JenovaCell/zero-rax/concept_b_stack.png

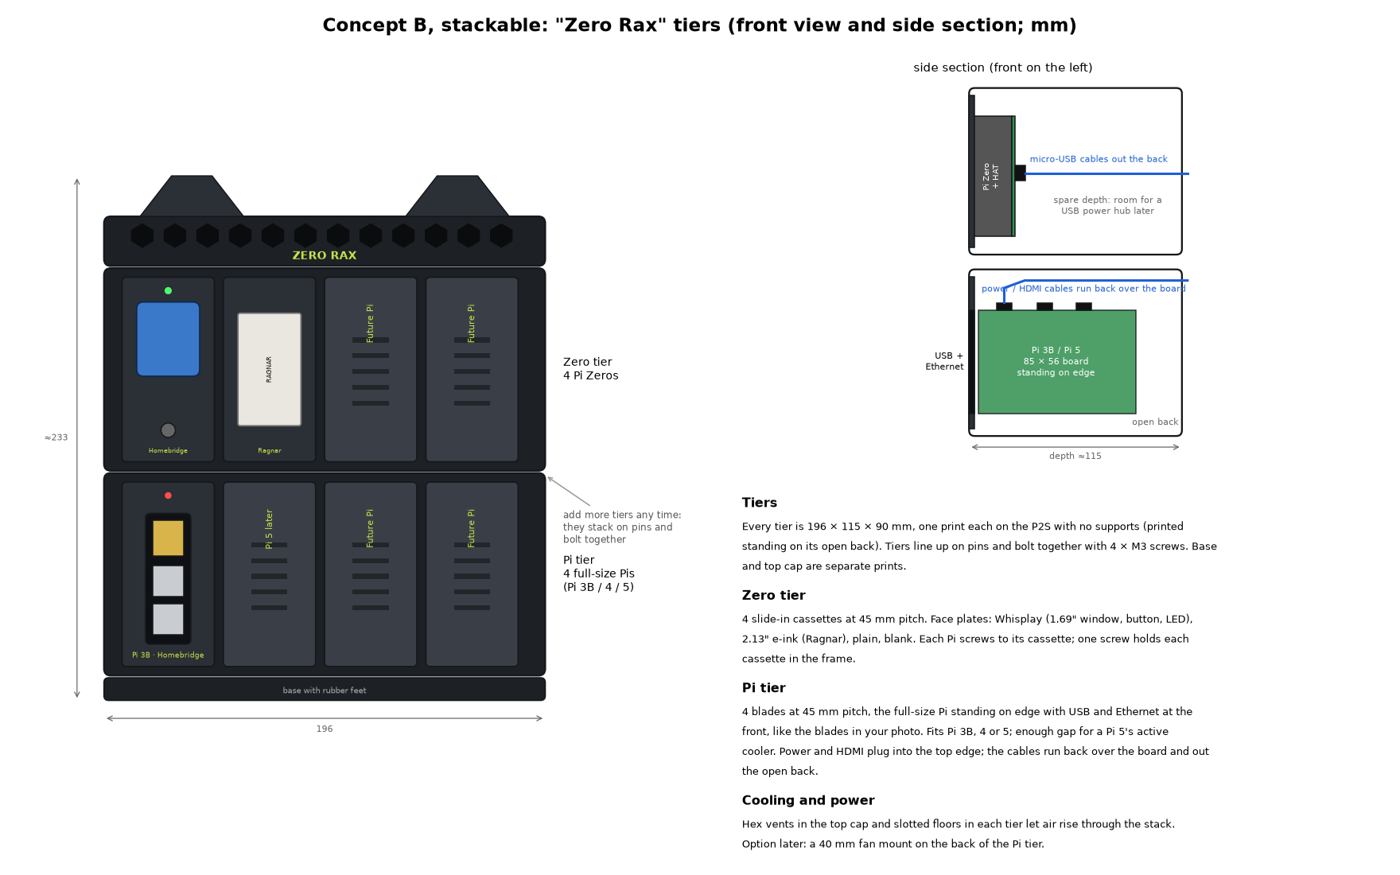
concept_b_stack.png
