JenovaCell/zero-rax/concepts.png

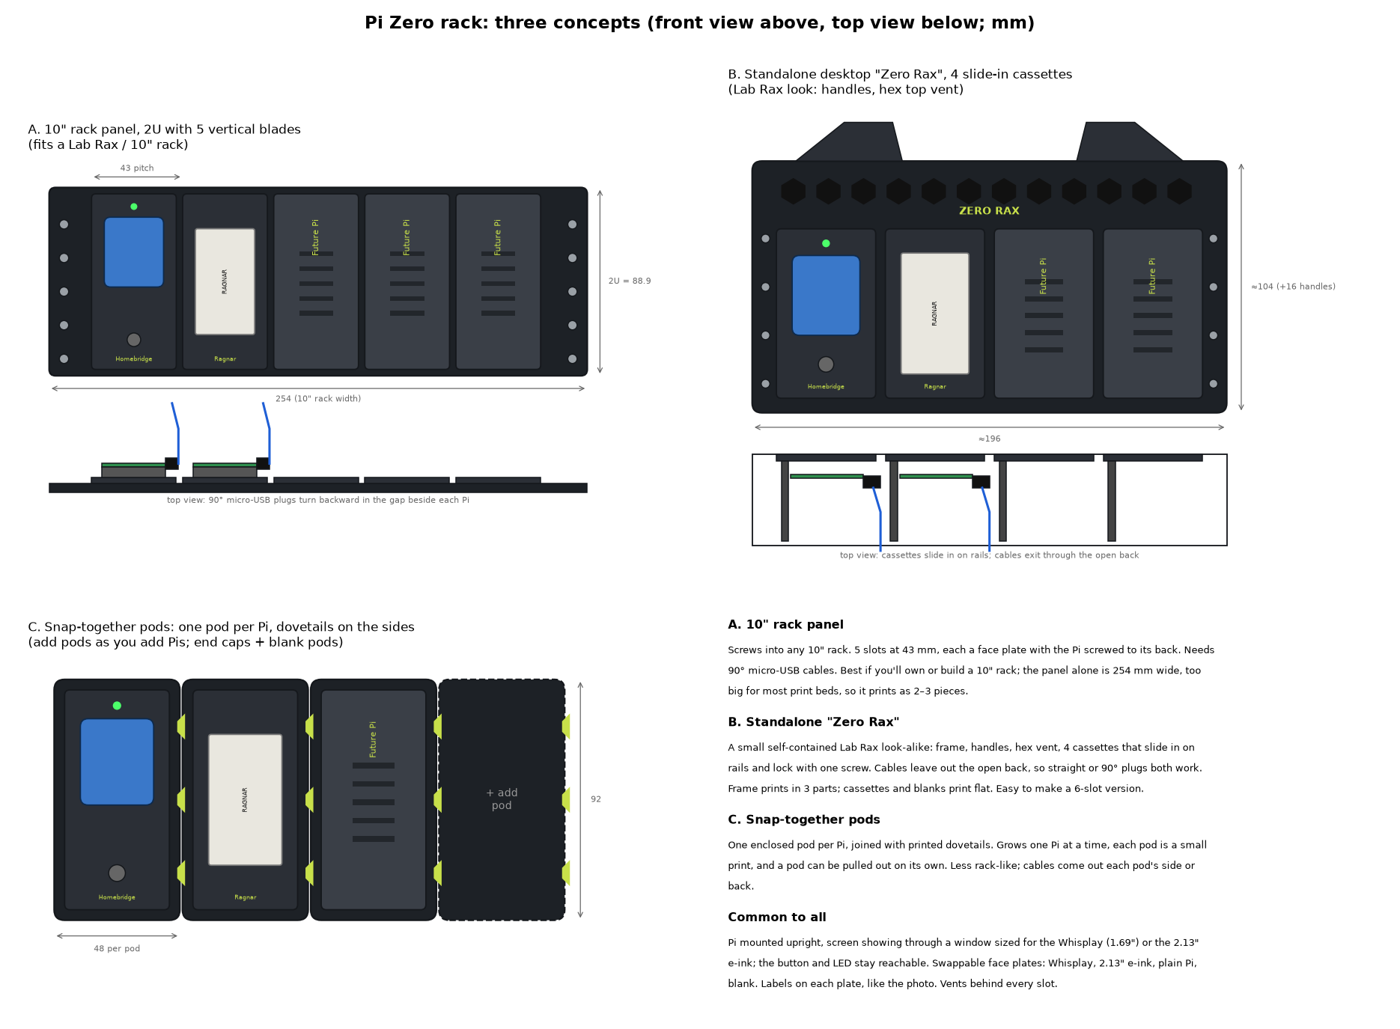
concepts.png
