JenovaCell/zero-rax/renders/straight_front.png

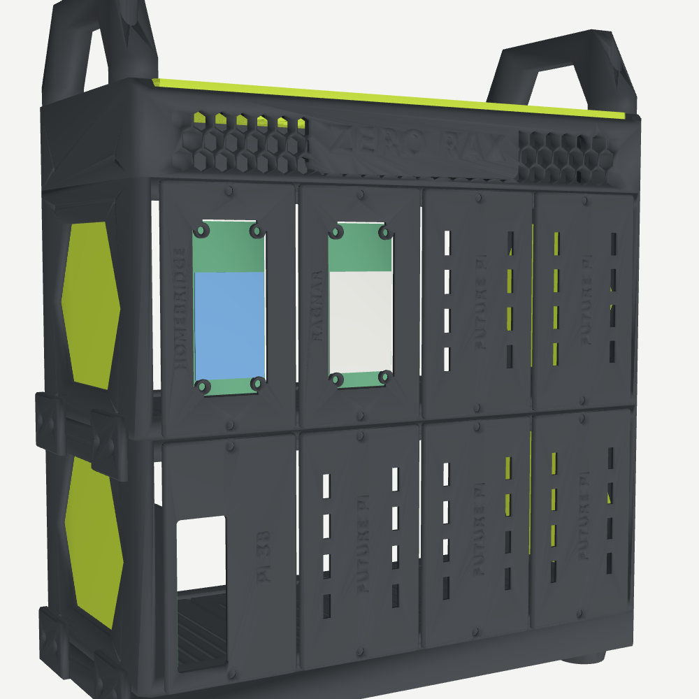
renders/straight_front.png
