JenovaCell/zero-rax/stl/cassette_homebridge.stl

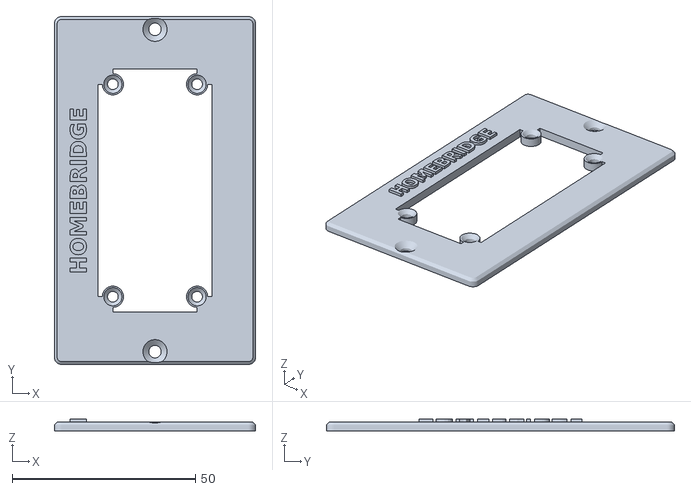
[picture p6: CAD file, 2026-09-28]
stl/cassette_homebridge.stl
55.0 x 95.0 x 3.30
