JenovaCell/zero-rax/zero_rax_black_plate4.3mf

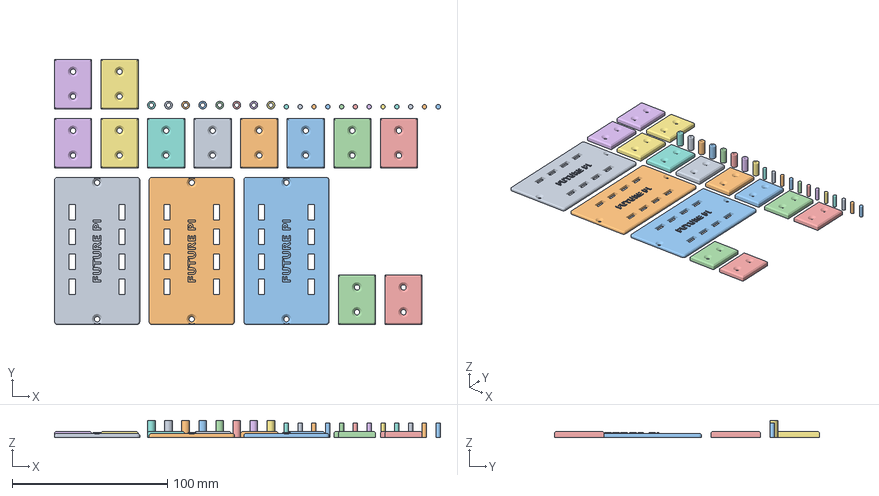
[picture p7: CAD file, 2026-09-28]
zero_rax_black_plate4.3mf
248.8 x 171.0 x 11.0 mm
blank_future_pi_0
blank_future_pi_1
blank_future_pi_2
clip_3
clip_4
clip_5
clip_6
clip_7
clip_8
clip_9
clip_10
clip_11
clip_12
clip_13
clip_14
zero_spacer_15
zero_spacer_16
zero_spacer_17
zero_spacer_18
zero_spacer_19
zero_spacer_20
zero_spacer_21
zero_spacer_22
dowel_23
dowel_24
dowel_25
dowel_26
dowel_27
dowel_28
dowel_29
dowel_30
dowel_31
dowel_32
dowel_33
dowel_34
