JenovaCell/zero-rax/stl/blade_pi3b.stl

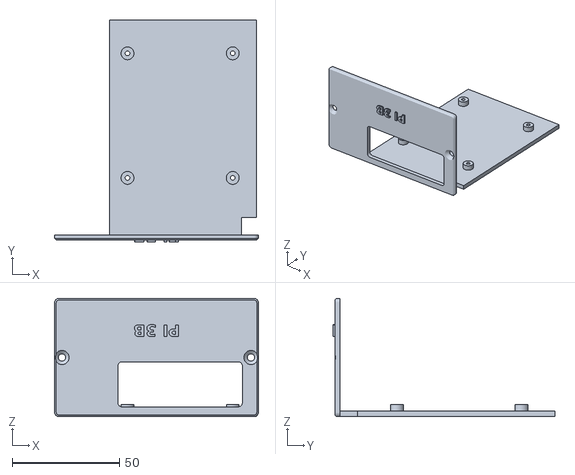
[picture p8: CAD file, 2026-09-28]
stl/blade_pi3b.stl
95.0 x 103.3 x 55.0
