JenovaCell/zero-rax/zero_rax_black_plate2.3mf

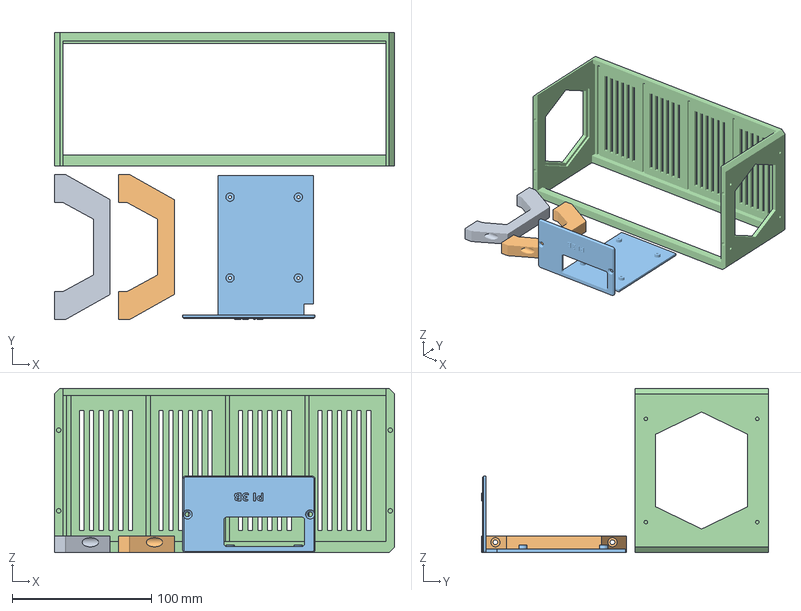
[picture p9: CAD file, 2026-09-28]
zero_rax_black_plate2.3mf
244.0 x 206.0 x 118.0 mm
handle_0
handle_1
blade_pi3b_2
tier_3
