JenovaCell/zero-rax/stl/zero_spacer.stl

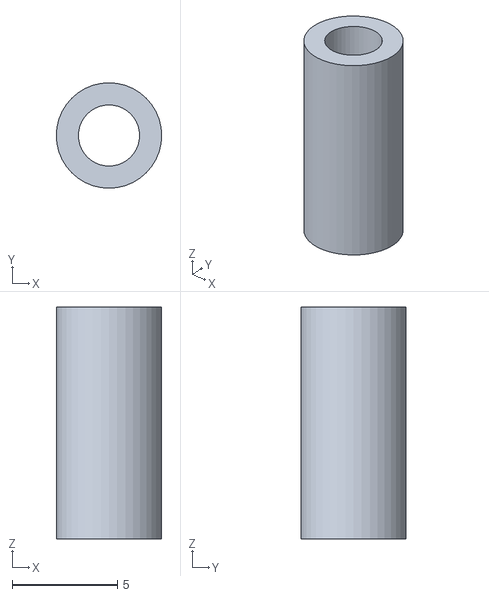
[picture p10: CAD file, 2026-09-28]
stl/zero_spacer.stl
5.00 x 5.00 x 11.0
