JenovaCell/zero-rax/zero_rax_lime_plate1.3mf

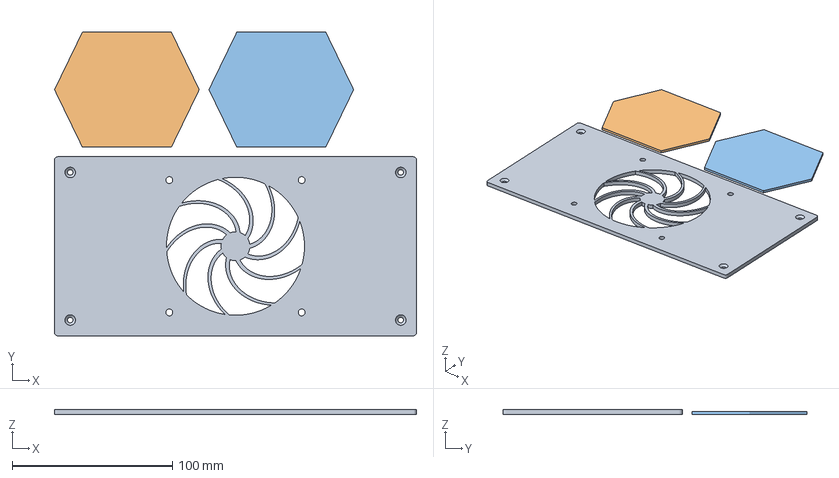
[picture p11: CAD file, 2026-09-28]
zero_rax_lime_plate1.3mf
225.6 x 189.2 x 3.00 mm
cap_panel_0
side_insert_1
side_insert_2
