JenovaCell/zero-rax/stl/side_insert.stl

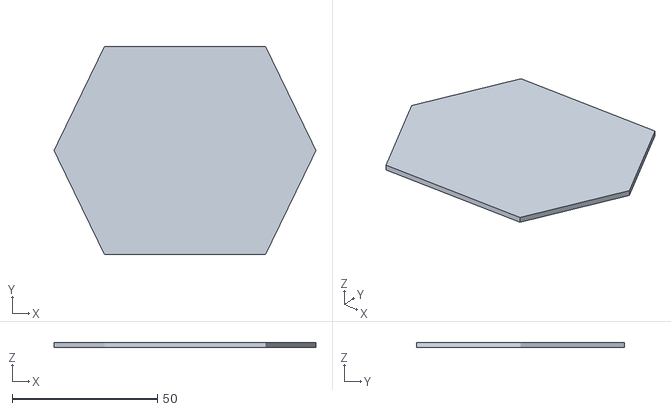
[picture p12: CAD file, 2026-09-28]
stl/side_insert.stl
90.2 x 71.6 x 1.80
