JenovaCell/zero-rax/zero_rax_black_plate3.3mf

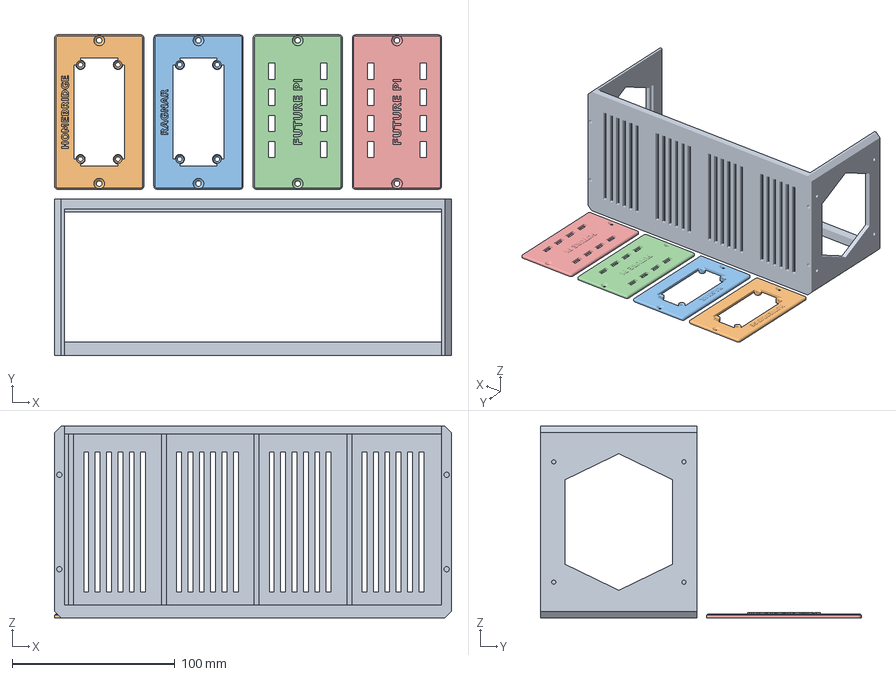
[picture p13: CAD file, 2026-09-28]
zero_rax_black_plate3.3mf
244.0 x 197.0 x 118.0 mm
tier_0
cassette_homebridge_1
cassette_ragnar_2
blank_future_pi_3
blank_future_pi_4
