JenovaCell/zero-rax/stl/dowel.stl

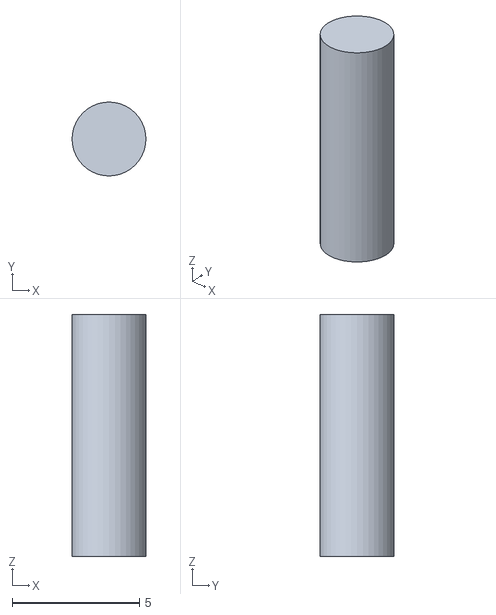
[picture p14: CAD file, 2026-09-28]
stl/dowel.stl
2.90 x 2.90 x 9.50
