JenovaCell/zero-rax/zero_rax_lime_plate2.3mf

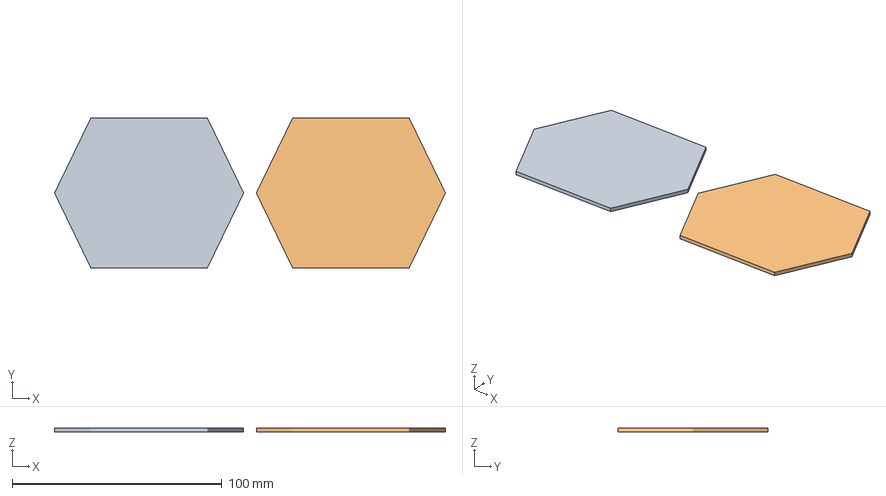
[picture p15: CAD file, 2026-09-28]
zero_rax_lime_plate2.3mf
186.4 x 71.6 x 1.80 mm
side_insert_0
side_insert_1
