JenovaCell/zero-rax/zero_rax_black_plate1.3mf

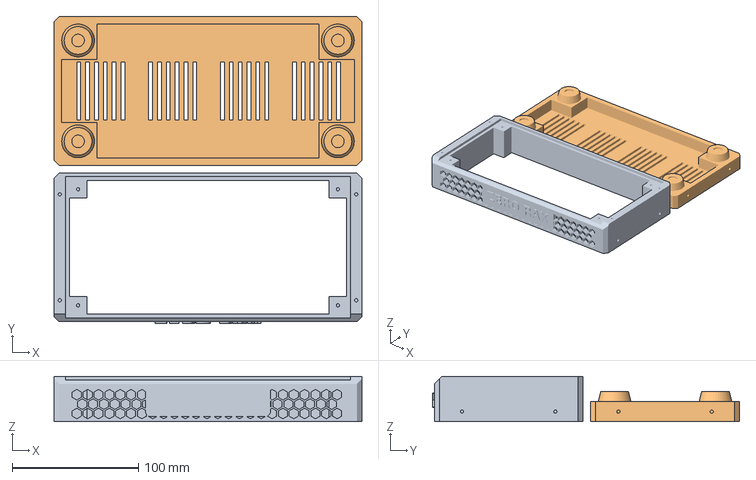
[picture p16: CAD file, 2026-09-28]
zero_rax_black_plate1.3mf
244.0 x 243.4 x 36.0 mm
cap_0
base_1
