JenovaCell/zero-rax/stl/handle.stl

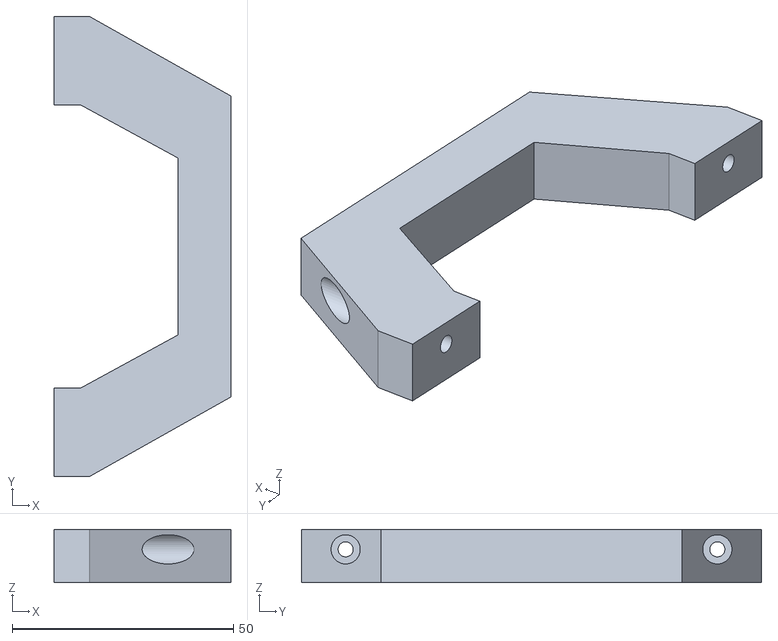
[picture p17: CAD file, 2026-09-28]
stl/handle.stl
40.0 x 104.0 x 12.0
