JenovaCell/zero-rax/stl/tier.stl

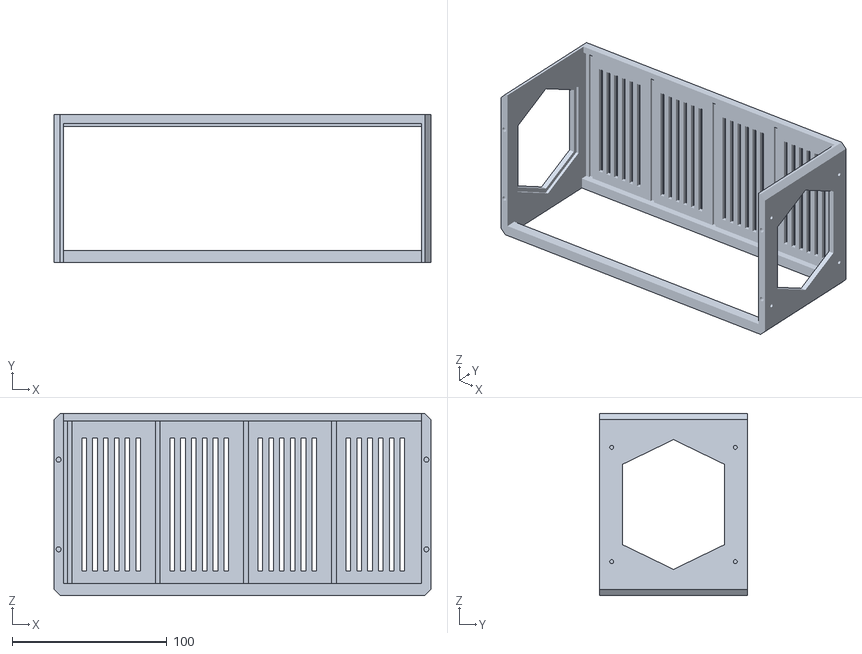
[picture p18: CAD file, 2026-09-28]
stl/tier.stl
244.0 x 96.0 x 118.0
