JenovaCell/zero-rax/stl/blank_future_pi.stl

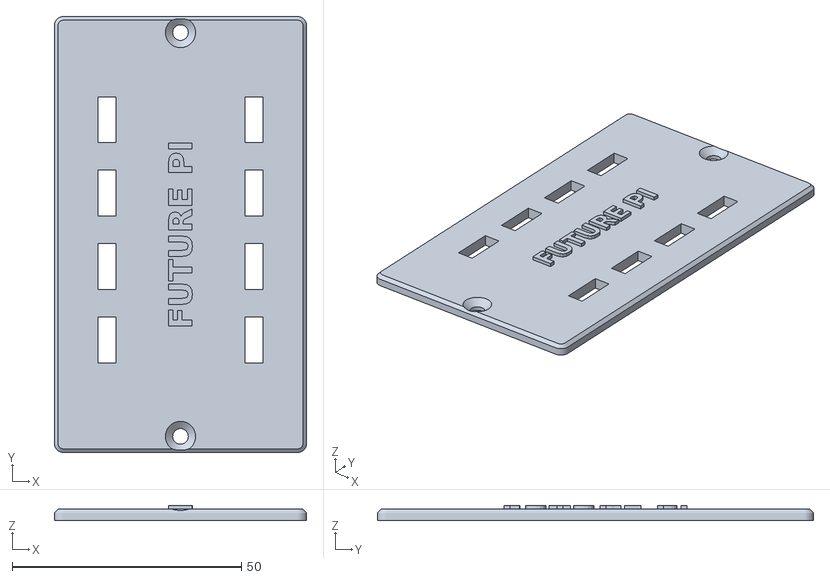
[picture p19: CAD file, 2026-09-28]
stl/blank_future_pi.stl
55.0 x 95.0 x 3.30
