JenovaCell/zero-rax/stl/cassette_ragnar.stl

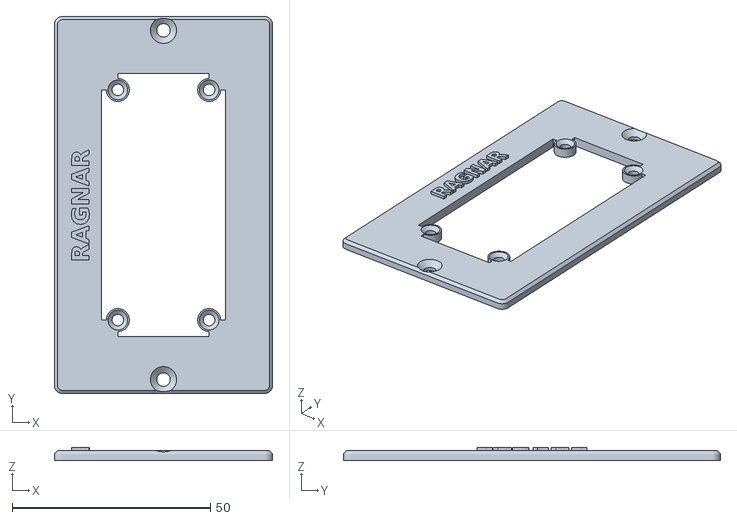
[picture p20: CAD file, 2026-09-28]
stl/cassette_ragnar.stl
55.0 x 95.0 x 3.30
