JenovaCell/zero-rax/stl/cap_panel.stl

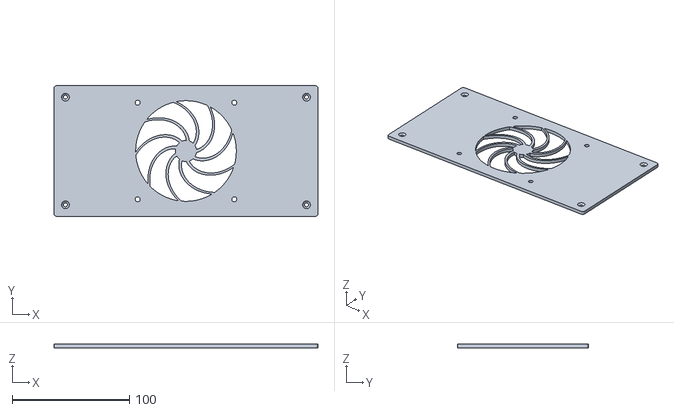
[picture p21: CAD file, 2026-09-28]
stl/cap_panel.stl
225.6 x 111.6 x 3.00
