JenovaCell/zero-rax/stl/base.stl

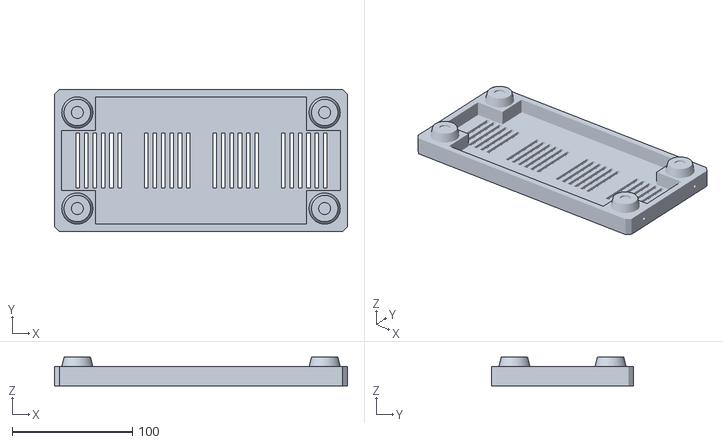
[picture p22: CAD file, 2026-09-28]
stl/base.stl
244.0 x 118.0 x 24.0
