JenovaCell/zero-rax/stl/cap.stl

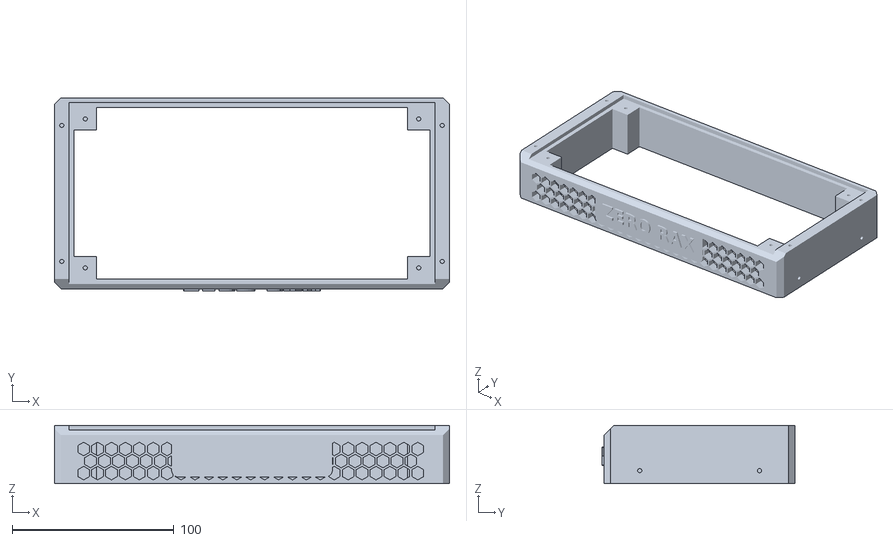
[picture p23: CAD file, 2026-09-28]
stl/cap.stl
244.0 x 119.4 x 36.0
