JenovaCell/zero-rax/stl/clip.stl

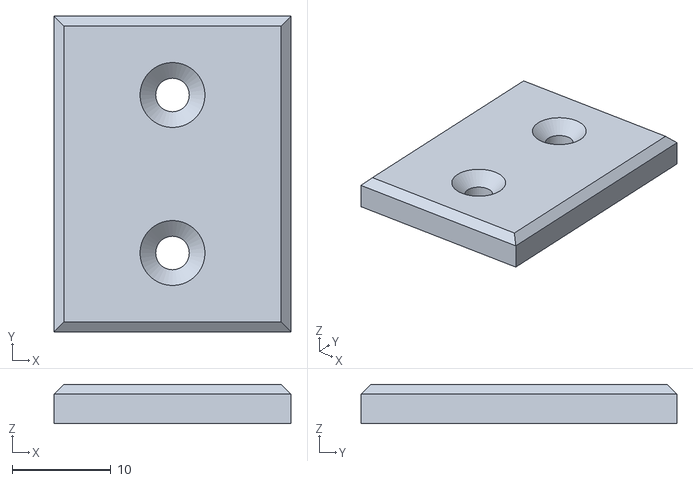
[picture p24: CAD file, 2026-09-28]
stl/clip.stl
24.0 x 32.0 x 4.00
