JenovaCell/zero-rax/(list of files, cad)

Other CAD files:
stl/blade_pi5.stl
