JenovaCell/zero-rax/(commit log)

2026-09-28 Add concept sketches for a modular Pi Zero rack
    Three options for housing the Homebridge display Pi and Ragnar, with
    room for more Pi Zeros: a 10" rack panel with vertical blades, a
    standalone desktop mini rack with slide-in cassettes, and snap-together
    pods. Sketch script included.
    Claude-Session: https://claude.ai/code/session_015X4tjJZgkpAF164NNZWiMK
2026-09-28 Add stackable-tier sketch for the Zero Rax concept
    Zero tier (4 Pi Zero cassettes) and Pi tier (4 full-size Pi blades for
    the Pi 3B and a future Pi 5), plus base and top cap, each sized for a
    256 mm print bed.
    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
2026-09-28 Add Zero Rax: stackable Lab Rax style rack for Pi Zeros and full-size Pis
    Base, two identical 4-slot tiers, and a cap with a hex-mesh name band,
    handles and a 92 mm fan under a lime swirl grille. Modules: Pi Zero
    cassettes (full-board window, so the Whisplay and 2.13" e-ink both fit),
    full-size Pi blades for a Pi 3B/4/5 with a USB/Ethernet window, and
    labelled blanks. Every part is support-free and fits a 256 mm bed; STLs
    in print orientation, six 3MF plates split by colour, a parametric
    generator, renders and a build guide.
    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
    [base.stl, blade_pi3b.stl, blade_pi5.stl, blank_future_pi.stl, cap.stl, cap_panel.stl, cassette_homebridge.stl, cassette_ragnar.stl]
